hsetlik/DualWavetableOsc/Panel/BoardScrnshotRev1.png

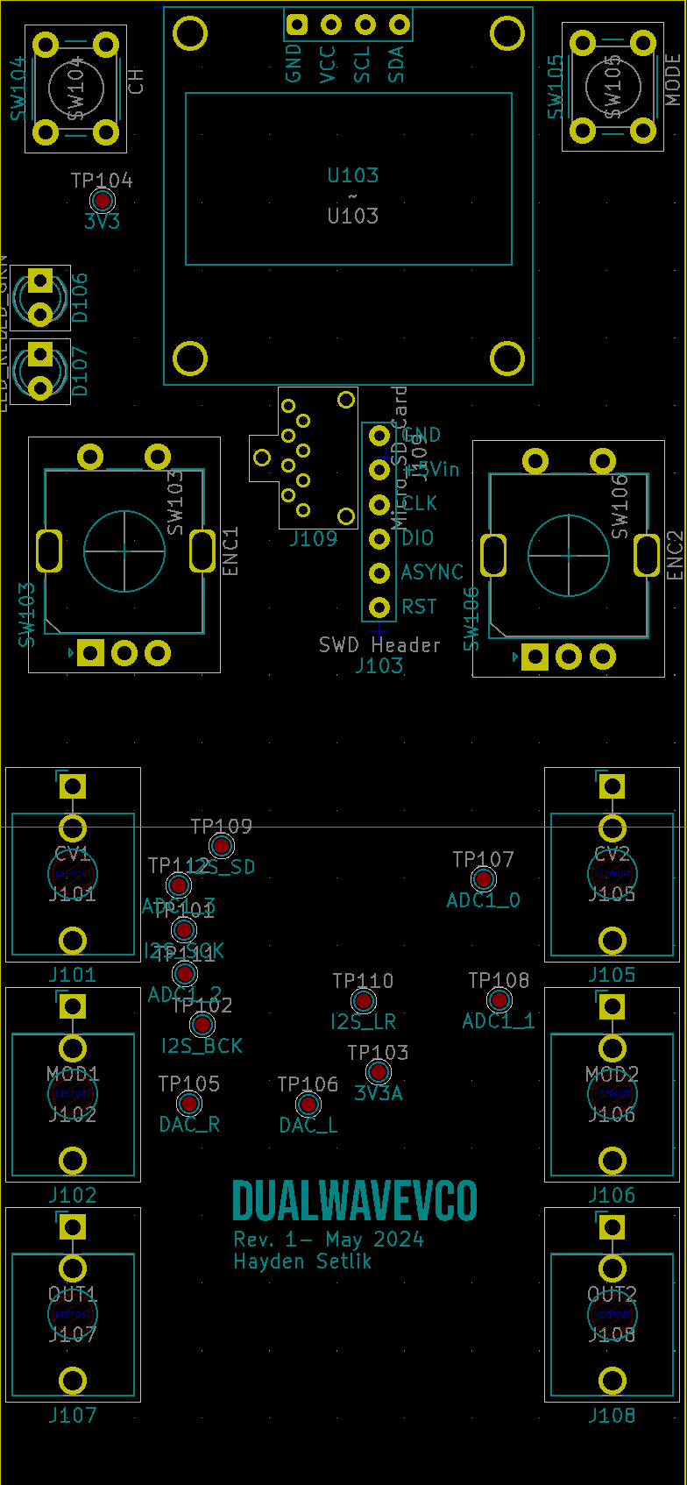
Panel/BoardScrnshotRev1.png
