hsetlik/DualWavetableOsc/DualWavetableOscHardware/DualWavetableOscHardware.kicad_pcb

## KiCad design DualWavetableOscHardware/DualWavetableOscHardware.kicad_pcb (2024-05-15)

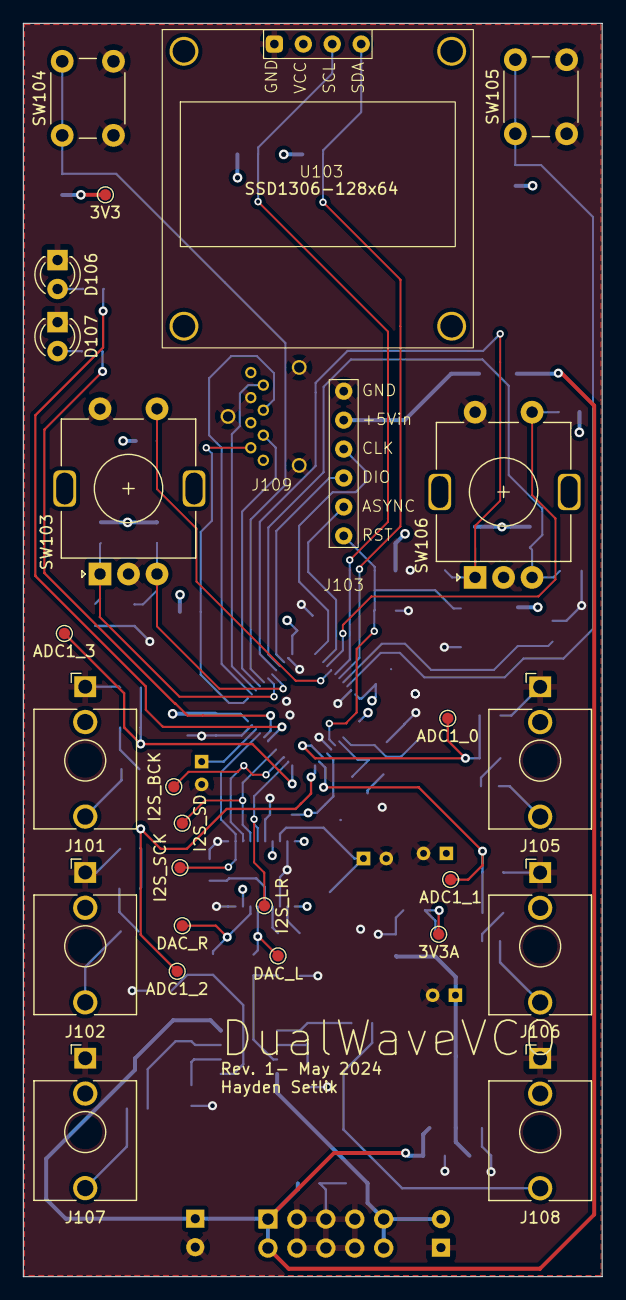
[picture p2: board DualWavetableOscHardware.kicad_pcb from above]

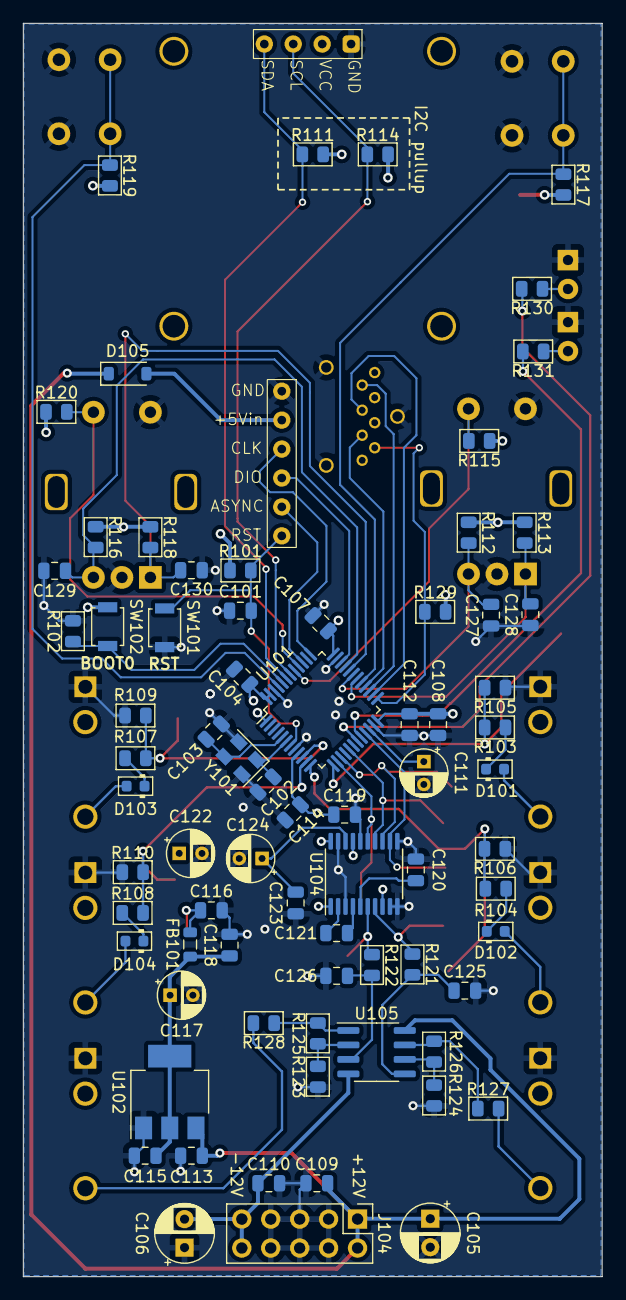
[picture p3: board DualWavetableOscHardware.kicad_pcb from below]

Board: 4 copper layers, 50.8 x 110.0 mm, 102 parts (75 on the bottom side), 62 nets.

Parts:
C101, C107, C108, C112, C113, C115, C119, C123, C127, C128, C129, C130: 100n; C_0805_2012Metric
C102, C103: 6pF; C_0805_2012Metric
C104, C116, C118: 2u2; C_0805_2012Metric
C105, C106: 10u; CP_Radial_D5.0mm_P2.50mm
C109, C110: 220n; C_0805_2012Metric
C111: 4u7; CP_Radial_D4.0mm_P2.00mm
C114: 10n; C_0805_2012Metric
C117, C122, C124: 10u; CP_Radial_D4.0mm_P2.00mm
C120, C121: 2.2u; C_0805_2012Metric
C125, C126: 2.2n; C_0805_2012Metric
D101, D102, D103, D104: D_Schottky; D_0603_1608Metric
D105: 1N4148; D_SOD-123
D106: LED_GRN; LED_D3.0mm
D107: LED_RED; LED_D3.0mm
FB101: 90R; L_0805_2012Metric
J101: CV1; Jack_3.5mm_QingPu_WQP-PJ398SM_Vertical_CircularHoles
J102: MOD1; Jack_3.5mm_QingPu_WQP-PJ398SM_Vertical_CircularHoles
J103: SWD Header; ST_SWHeader_3Wire_Pin
J104: POWER; PinHeader_2x05_P2.54mm_Vertical
J105: CV2; Jack_3.5mm_QingPu_WQP-PJ398SM_Vertical_CircularHoles
J106: MOD2; Jack_3.5mm_QingPu_WQP-PJ398SM_Vertical_CircularHoles
J107: OUT1; Jack_3.5mm_QingPu_WQP-PJ398SM_Vertical_CircularHoles
J108: OUT2; Jack_3.5mm_QingPu_WQP-PJ398SM_Vertical_CircularHoles
J109: Micro_SD_Card; microSD_Genesis_Vertical_THT
R101: 47k; R_0805_2012Metric
R102, R112, R113, R115, R116, R117, R118, R119, R120, R129: 10k; R_0805_2012Metric
R103, R104, R107, R108, R123, R124: 100k; R_0805_2012Metric
R105, R106, R109, R110: 33k; R_0805_2012Metric
R111, R114: R_PULLUP; R_0805_2012Metric
R121, R122, R127, R128: 470; R_0805_2012Metric
R125, R126: 68k; R_0805_2012Metric
R130, R131: 220; R_0805_2012Metric
SW101: RST; SW_SPST_B3U-1000P
SW102: BOOT; SW_SPST_B3U-1000P
SW103: ENC1; RotaryEncoder_Alps_EC11E-Switch_Vertical_H20mm_5Pin
SW104: CH; SW_PUSH_6mm
SW105: MODE; SW_PUSH_6mm
SW106: ENC2; RotaryEncoder_Alps_EC11E-Switch_Vertical_H20mm_5Pin
TP101: I2S_SCK; TestPoint_Pad_D1.0mm_Value
TP102: I2S_BCK; TestPoint_Pad_D1.0mm_Value
TP103: 3V3A; TestPoint_Pad_D1.0mm_Value
TP104: 3V3; TestPoint_Pad_D1.0mm_Value
TP105: DAC_R; TestPoint_Pad_D1.0mm_Value
TP106: DAC_L; TestPoint_Pad_D1.0mm_Value
TP107: ADC1_0; TestPoint_Pad_D1.0mm_Value
TP108: ADC1_1; TestPoint_Pad_D1.0mm_Value
TP109: I2S_SD; TestPoint_Pad_D1.0mm_Value
TP110: I2S_LR; TestPoint_Pad_D1.0mm_Value
TP111: ADC1_2; TestPoint_Pad_D1.0mm_Value
TP112: ADC1_3; TestPoint_Pad_D1.0mm_Value
U101: STM32F410CBTx; LQFP-48_7x7mm_P0.5mm
U102: AMS1117; SOT-223-3_TabPin2
U103: SSD1306-128x64; SSD1306_OLED_128x64
U104: PCM5100A; TSSOP-20_4.4x6.5mm_P0.65mm
U105: TL072; SOIC-8_3.9x4.9mm_P1.27mm
Y101: 16MHz; Crystal_SMD_EuroQuartz_MT-4Pin_3.2x2.5mm

Connections:
+3.3V: C104.1, C107.1, C108.1, C112.1, C115.2, C117.1, C118.1, FB101.1, J109.4 (VDD), R101.1, R111.2, R112.1, R113.1, R114.2, R115.1, R116.1, R117.2, R118.1, R119.2, R120.1, R129.2, SW102.1 (A), TP104.1, U101.1 (VBAT), U101.24 (VDD), U101.36 (VDD), U101.47 (PDR_ON), U101.48 (VDD), U102.2 (VO), U103.2 (VCC)
+3.3VA: C114.1, C116.1, C119.1, C122.1, FB101.2, TP103.1, U101.9 (VDDA), U104.1 (CPVDD), U104.8 (AVDD), U104.17 (XSMT), U104.20 (DVDD)
+12V: C105.1, C109.2, C113.2, D105.1 (K), J104.1, J104.2, U102.3 (VI), U105.8 (V+)
-12V: C106.2, C110.1, J104.9, J104.10, U105.4 (V-)
BOOT0: R102.1, SW102.2 (B), U101.44 (BOOT0)
CH_BTN: R117.1, SW104.1 (A), U101.29 (PA8)
CV1: D101.2 (A), J101.T
CV1_ADC: R103.2, R105.2, TP112.1, U101.13 (PA3)
CV2: D103.2 (A), J105.T
CV2_ADC: R107.2, R109.2, TP107.1, U101.10 (PA0)
ENC1_B: R115.2, SW103.S1, U101.41 (PB5)
ENC1_L: C128.2, R113.2, SW103.A, U101.30 (PA9)
ENC1_R: C127.2, R112.2, SW103.B, U101.31 (PA10)
ENC2_B: R120.2, SW106.S1, U101.40 (PB4)
ENC2_L: C130.2, R118.2, SW106.A, U101.32 (PA11)
ENC2_R: C129.2, R116.2, SW106.B, U101.33 (PA12)
GND: C101.1, C102.1, C103.1, C104.2, C105.2, C106.1, C107.2, C108.2, C109.1, C110.2, C111.2, C112.2, C113.1, C114.2, C115.1, C116.2, C117.2, C118.2, C119.2, C120.2, C122.2, C123.2, C124.2, C125.2, C126.2, C127.1, C128.1, C129.1, C130.1, D106.1 (K), D107.1 (K), J101.S, J102.S, J103.1 (GND), J104.3, J104.4, J104.5, J104.6, J104.7, J104.8, J105.S, J106.S, J107.S, J108.S, J109.6 (VSS), J109.9 (SHIELD), R102.2, R105.1, R106.1, R109.1, R110.1, R123.1, R124.1, SW101.2 (B), SW103.C, SW103.S2, SW104.2 (B), SW105.2 (B), SW106.C, SW106.S2, U101.8 (VSSA), U101.23 (VSS), U101.35 (VSS), U101.46 (VSS), U102.1 (ADJ), U103.1 (GND), U104.3 (CPGND), U104.9 (AGND), U104.10 (DEMP), U104.11 (FLT), U104.16 (FMT), U104.19 (DGND), Y101.2, Y101.4
HSE_IN: C103.2, U101.5 (PH0), Y101.3
HSE_OUT: C102.2, U101.6 (PH1), Y101.1
I2S_BCK: TP102.1, U101.15 (PA5), U104.13 (BCK)
I2S_DIO: TP109.1, U101.17 (PA7), U104.14 (DIN)
I2S_SCK: TP101.1, U101.21 (PB10), U104.12 (SCK)
I2S_WS: TP110.1, U101.14 (PA4), U104.15 (LRCK)
LED_GRN: R130.2, U101.19 (PB1)
LED_RED: R131.2, U101.20 (PB2)
MISO: J109.7 (DAT0), U101.27 (PB14)
MOD1: D102.2 (A), J102.T
MOD1_ADC: R104.2, R106.2, TP111.1, U101.12 (PA2)
MOD2: D104.2 (A), J106.T
MOD2_ADC: R108.2, R110.2, TP108.1, U101.11 (PA1)
MODE_BTN: R119.1, SW105.1 (A), U101.45 (PB8)
MOSI: J109.3 (CMD), U101.28 (PB15)
NRST: C101.2, J103.6 (RST), R101.2, SW101.1 (A), U101.7 (NRST)
unnamed: D101.1 (K), R103.1
unnamed: D102.1 (K), R104.1
unnamed: D103.1 (K), R107.1
unnamed: D104.1 (K), R108.1
unnamed: D106.2 (A), R130.1
unnamed: D107.2 (A), R131.1
unnamed: R125.2, R128.1, U105.1
unnamed: R126.2, R127.1, U105.7
unnamed: C111.1, U101.22 (VCAP1)
unnamed: C121.2, U104.4 (CAPM)
unnamed: C121.1, U104.2 (CAPP)
unnamed: C123.1, C124.1, U104.18 (LDOO)
unnamed: R122.1, TP106.1, U104.6 (OUTL)
unnamed: R121.1, TP105.1, U104.7 (OUTR)
unnamed: C120.1, U104.5 (VNEG)
unnamed: C126.1, R122.2, U105.3 (+)
unnamed: R123.2, R125.1, U105.2 (-)
unnamed: C125.1, R121.2, U105.5 (+)
unnamed: R124.2, R126.1, U105.6 (-)
Out1: J107.T, R127.2
Out2: J108.T, R128.2
SCK: J109.5 (CLK), U101.26 (PB13)
SCL: R114.1, U101.42 (PB6), U103.3 (SCL)
SDA: R111.1, U101.43 (PB7), U103.4 (SDA)
SD_CS: J109.2 (DAT3/CD), R129.1, U101.25 (PB12)
SWCLK: J103.3 (SWCLK), U101.37 (PA14)
SWDIO: J103.4 (SWDIO), U101.34 (PA13)
SWO: J103.5 (SWO), U101.39 (PB3)
VCC_DEBUG: D105.2 (A), J103.2 (VCC)
