hsetlik/DualWavetableOsc/Core/Src/main.c

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
/* Includes ------------------------------------------------------------------*/
#include "main.h"

/* USER CODE BEGIN Includes */
#include <stdio.h>


#include "StatusLEDs.h"
/* USER CODE END Includes */

/* USER CODE BEGIN PD */

#define BUFFER_SIZE 128
#define FLOAT_TO_INT16 32768.0f

/* USER CODE END PD */

ADC_HandleTypeDef hadc1;
DMA_HandleTypeDef hdma_adc1;

I2C_HandleTypeDef hi2c1;

I2S_HandleTypeDef hi2s1;
DMA_HandleTypeDef hdma_spi1_tx;

SPI_HandleTypeDef hspi2;

/* USER CODE BEGIN PV */
int16_t dacData[BUFFER_SIZE];
static volatile int16_t* outBufPtr = &dacData[0];
uint8_t audioDataReadyFlag;

status_led_t leds;

//

/* USER CODE END PV */

void SystemClock_Config(void);
static void MX_GPIO_Init(void);
static void MX_DMA_Init(void);
static void MX_ADC1_Init(void);
static void MX_I2C1_Init(void);
static void MX_I2S1_Init(void);
static void MX_SPI2_Init(void);
/* USER CODE BEGIN 0 */
// I2S callbacks
// transmit is half complete
void HAL_I2S_TxHalfCpltCallback(I2S_HandleTypeDef *hi2s)
{
	outBufPtr = &dacData[0];
	audioDataReadyFlag = 1;
}


// transmit is complete
void HAL_I2S_TxCpltCallback(I2S_HandleTypeDef *hi2s)
{
	outBufPtr = &dacData[BUFFER_SIZE / 2];
	audioDataReadyFlag = 1;
}


// renders the next chunk of the audio buffers to give to the DMA
void processAudioBuffer()
{
	static float leftOut, rightOut;
	for(uint8_t i = 0; i < (BUFFER_SIZE / 2) - 1; i += 2){
		///TODO: logic to determine the value of the samples goes here
		dacData[i] = (int16_t)(leftOut * FLOAT_TO_INT16);
		dacData[i + 1] = (int16_t)(rightOut * FLOAT_TO_INT16);
	}
	audioDataReadyFlag = 0;

}

/* USER CODE END 0 */

/**
  * @brief  The application entry point.
  * @retval int
  */
int main(void)
{

  /* MCU Configuration--------------------------------------------------------*/

  /* Reset of all peripherals, Initializes the Flash interface and the Systick. */
  HAL_Init();

  /* Configure the system clock */
  SystemClock_Config();

  /* Initialize all configured peripherals */
  MX_GPIO_Init();
  MX_DMA_Init();
  MX_ADC1_Init();
  MX_I2C1_Init();
  MX_I2S1_Init();
  MX_SPI2_Init();
  /* USER CODE BEGIN 2 */
  // start the  I2S DMA stream
  HAL_StatusTypeDef result = HAL_I2S_Transmit_DMA(&hi2s1, (uint16_t*)dacData, BUFFER_SIZE);
  if(result != HAL_OK){
	  status_error(leds);
  }
  status_normal(leds);

  /* USER CODE END 2 */

  /* Infinite loop */
  /* USER CODE BEGIN WHILE */
  uint32_t now = 0;
  uint32_t prev = 0;
  while (1)
  {
	  if(audioDataReadyFlag){
		  processAudioBuffer();
	  }
	  now = HAL_GetTick();
	  if(now - prev > 5)
	  {
		  prev = now;
		  tick_status_led(leds, now);
	  }
    /* USER CODE END WHILE */

    /* USER CODE BEGIN 3 */
  }
  /* USER CODE END 3 */
}

//---------------------------------------------------------------------------------------------------
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
/* USER CODE BEGIN 4 */

int _write(int file, char *ptr, int len)
{
  (void)file;
  int DataIdx;

  for (DataIdx = 0; DataIdx < len; DataIdx++)
  {
    ITM_SendChar(*ptr++);
  }
  return len;
}


/* USER CODE END 4 */
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
