hsetlik/DualWavetableOsc/DualWavetableOsc.ioc

Mcu.UserName=STM32F410CBTx
PA0-WKUP.GPIO_Label=CV2
PA0-WKUP.Signal=ADCx_IN0
PA1.GPIO_Label=MOD2
PA1.Signal=ADCx_IN1
PA10.GPIO_Label=ENC2_R
PA10.Signal=GPIO_Input
PA11.GPIO_Label=ENC1_L
PA11.Signal=GPIO_Input
PA12.GPIO_Label=ENC1_R
PA12.Signal=GPIO_Input
PA13.Signal=SYS_JTMS-SWDIO
PA14.Signal=SYS_JTCK-SWCLK
PA2.GPIO_Label=MOD1
PA2.Signal=ADCx_IN2
PA3.GPIO_Label=CV1
PA3.Signal=ADCx_IN3
PA4.Signal=I2S1_WS
PA5.Signal=I2S1_CK
PA7.Signal=I2S1_SD
PA8.GPIO_Label=CH_BTN
PA8.Signal=GPIO_Input
PA9.GPIO_Label=ENC2_L
PA9.Signal=GPIO_Input
PB1.GPIO_Label=LED_GRN
PB1.Signal=GPIO_Output
PB10.Signal=I2S1_MCK
PB12.GPIO_Label=SD_CS
PB12.Signal=GPIO_Input
PB13.Signal=SPI2_SCK
PB14.Signal=SPI2_MISO
PB15.Signal=SPI2_MOSI
PB2.GPIO_Label=LED_RED
PB2.Signal=GPIO_Output
PB3.Signal=SYS_JTDO-SWO
PB4.GPIO_Label=ENC2_B
PB4.Signal=GPIO_Input
PB5.GPIO_Label=ENC1_B
PB5.Signal=GPIO_Input
PB6.Signal=I2C1_SCL
PB7.Signal=I2C1_SDA
PB8.GPIO_Label=MODE_BTN
PB8.Signal=GPIO_Input
