hsetlik/DualWavetableOsc/Core/Inc/main.h

#define CV2_Pin GPIO_PIN_0
#define CV2_GPIO_Port GPIOA
#define MOD2_Pin GPIO_PIN_1
#define MOD2_GPIO_Port GPIOA
#define MOD1_Pin GPIO_PIN_2
#define MOD1_GPIO_Port GPIOA
#define CV1_Pin GPIO_PIN_3
#define CV1_GPIO_Port GPIOA
#define LED_GRN_Pin GPIO_PIN_1
#define LED_GRN_GPIO_Port GPIOB
#define LED_RED_Pin GPIO_PIN_2
#define LED_RED_GPIO_Port GPIOB
#define SD_CS_Pin GPIO_PIN_12
#define SD_CS_GPIO_Port GPIOB
#define CH_BTN_Pin GPIO_PIN_8
#define CH_BTN_GPIO_Port GPIOA
#define ENC2_L_Pin GPIO_PIN_9
#define ENC2_L_GPIO_Port GPIOA
#define ENC2_R_Pin GPIO_PIN_10
#define ENC2_R_GPIO_Port GPIOA
#define ENC1_L_Pin GPIO_PIN_11
#define ENC1_L_GPIO_Port GPIOA
#define ENC1_R_Pin GPIO_PIN_12
#define ENC1_R_GPIO_Port GPIOA
#define ENC2_B_Pin GPIO_PIN_4
#define ENC2_B_GPIO_Port GPIOB
#define ENC1_B_Pin GPIO_PIN_5
#define ENC1_B_GPIO_Port GPIOB
#define MODE_BTN_Pin GPIO_PIN_8
#define MODE_BTN_GPIO_Port GPIOB
