hsetlik/DualWavetableOsc/(commit log)

2024-05-11 schematic files
    [DualWavetableOscHardware.kicad_pcb, DualWavetableOscHardware.kicad_sch]
2024-05-11 rough schematic
    [DualWavetableOscHardware.kicad_sch]
2024-05-13 pcb rev 1
    [DualWavetableOscHardware.kicad_pcb, DualWavetableOscHardware.kicad_sch]
2024-05-13 double buffer for I2S
    [DualWavetableOscHardware.kicad_pcb, DualWavetableOscHardware.kicad_sch]
2024-05-13 added OLED driver
2024-05-13 actually added OLED driver
2024-05-13 status LEDs and test points
    [DualWavetableOscHardware.kicad_pcb, DualWavetableOscHardware.kicad_sch]
2024-05-13 status LED code
    [DualWavetableOscHardware.kicad_pcb, DualWavetableOscHardware.kicad_sch]
2024-05-13 ADC stuff
2024-05-14 printf debugging stuff
2024-05-14 new stackup/routing
    [DualWavetableOscHardware.kicad_pcb, DualWavetableOscHardware.kicad_sch]
2024-05-15 wavetable generation
    [DualWavetableOscHardware.kicad_pcb]
2024-05-15 wavetable voice logic
    [DualWavetableOscHardware.kicad_pcb, DualWavetableOscHardware.kicad_sch]
